katepavlu/MICROMOUSE/PCB/electronix.pdf

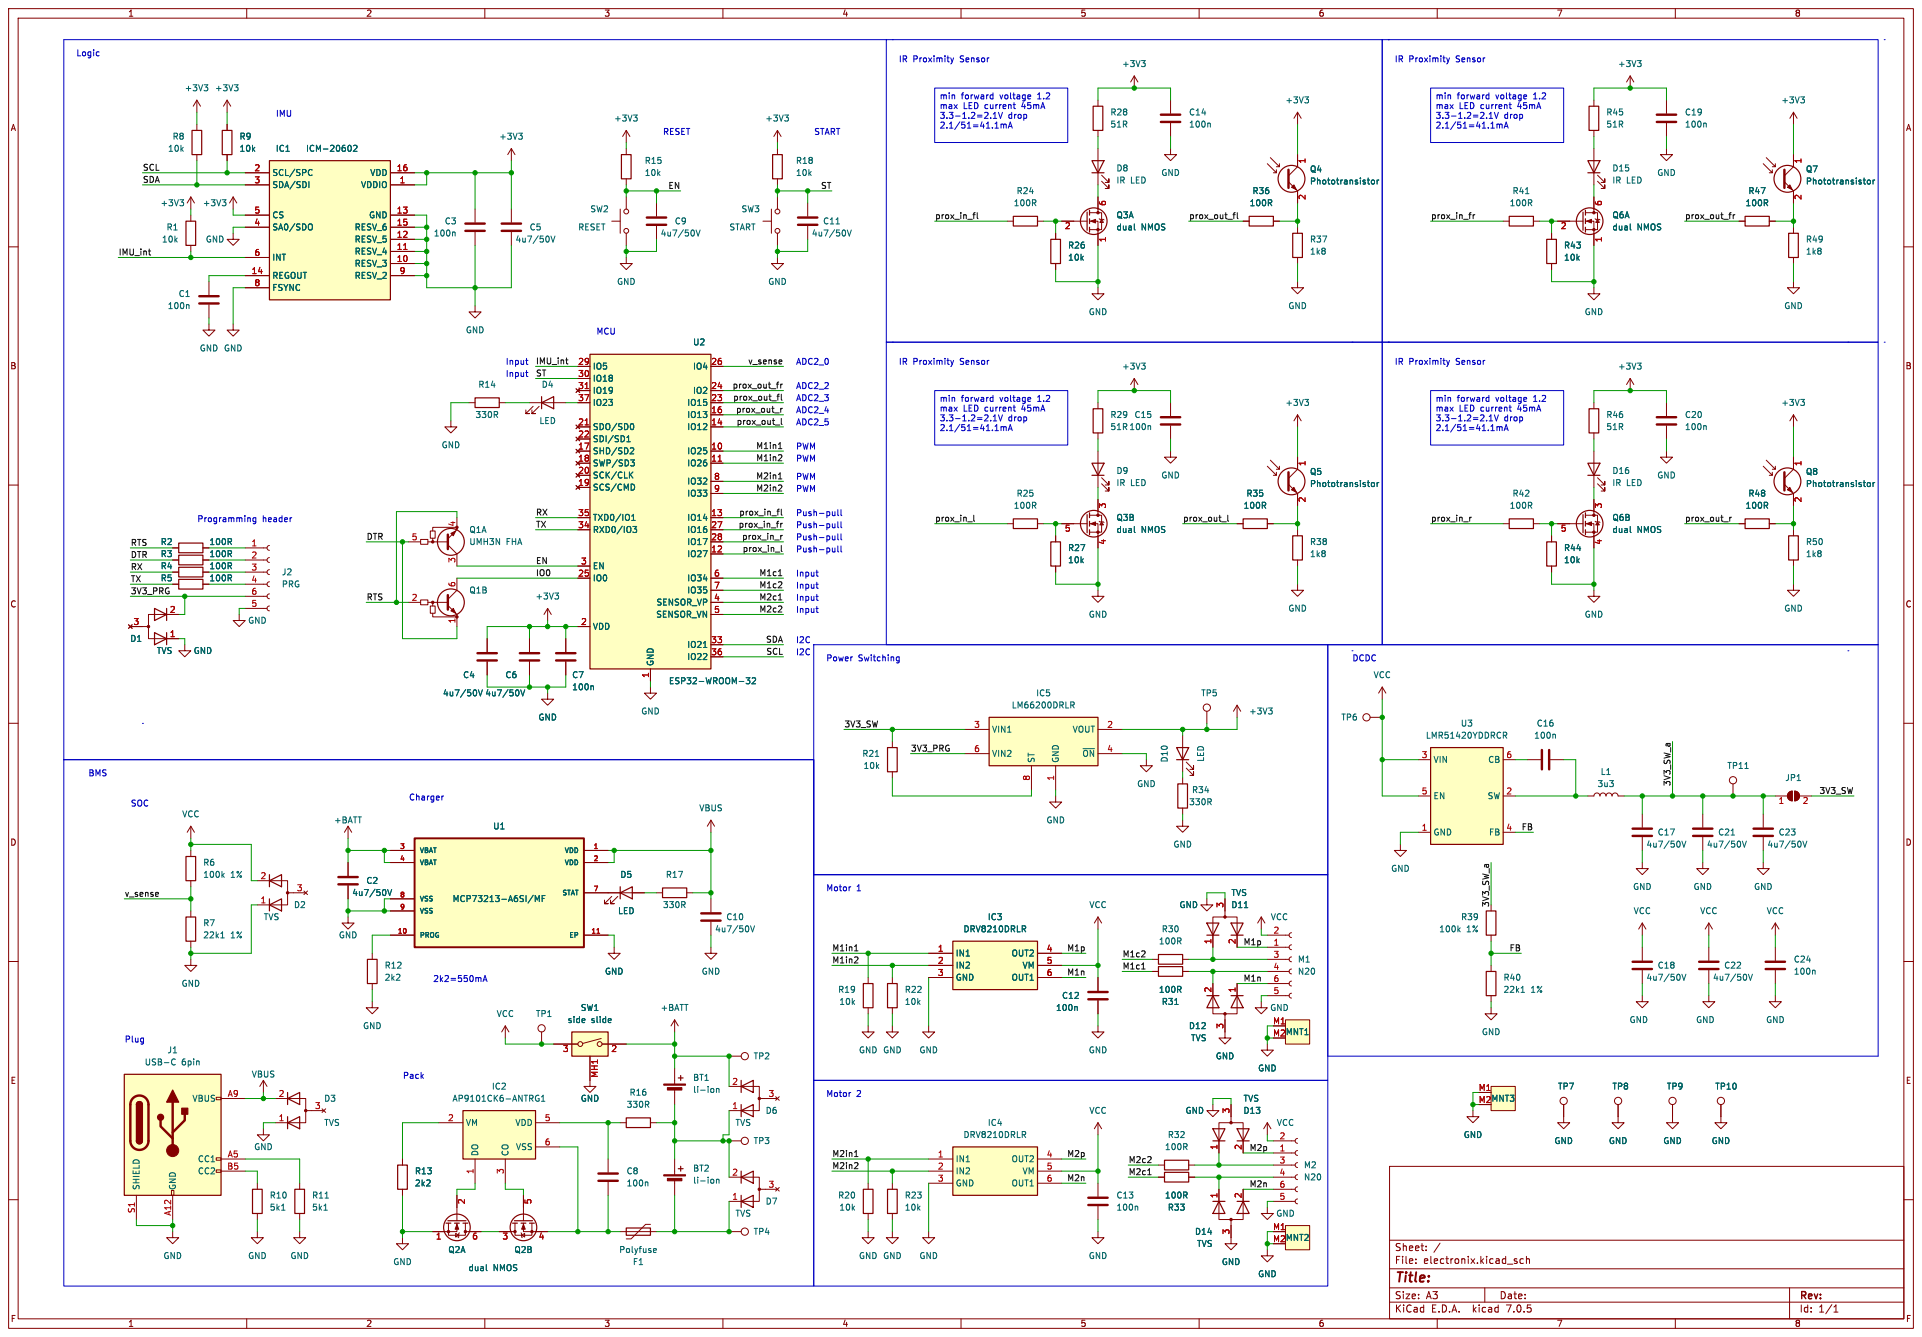
[picture p1: page 1]

2.1/51=41.1mA min forward voltage 1.2 max LED current 45mA

IO33 9 U2 ESP32-WROOM-32 D4
prox_out_fr v_sense ST
IO13 16 SHD/SD2 17 SWP/SD3 18 SCS/CMD 19 VDD 2 SCK/CLK 20 SDO/SD0 21 SDI/SD1 22

10k U2 ESP32-WROOM-32 GND

Push-pullPower Switching Motor 2
