katepavlu/MICROMOUSE/PCB/electronix.kicad_pcb

## KiCad design PCB/electronix.kicad_pcb (2023-08-06)

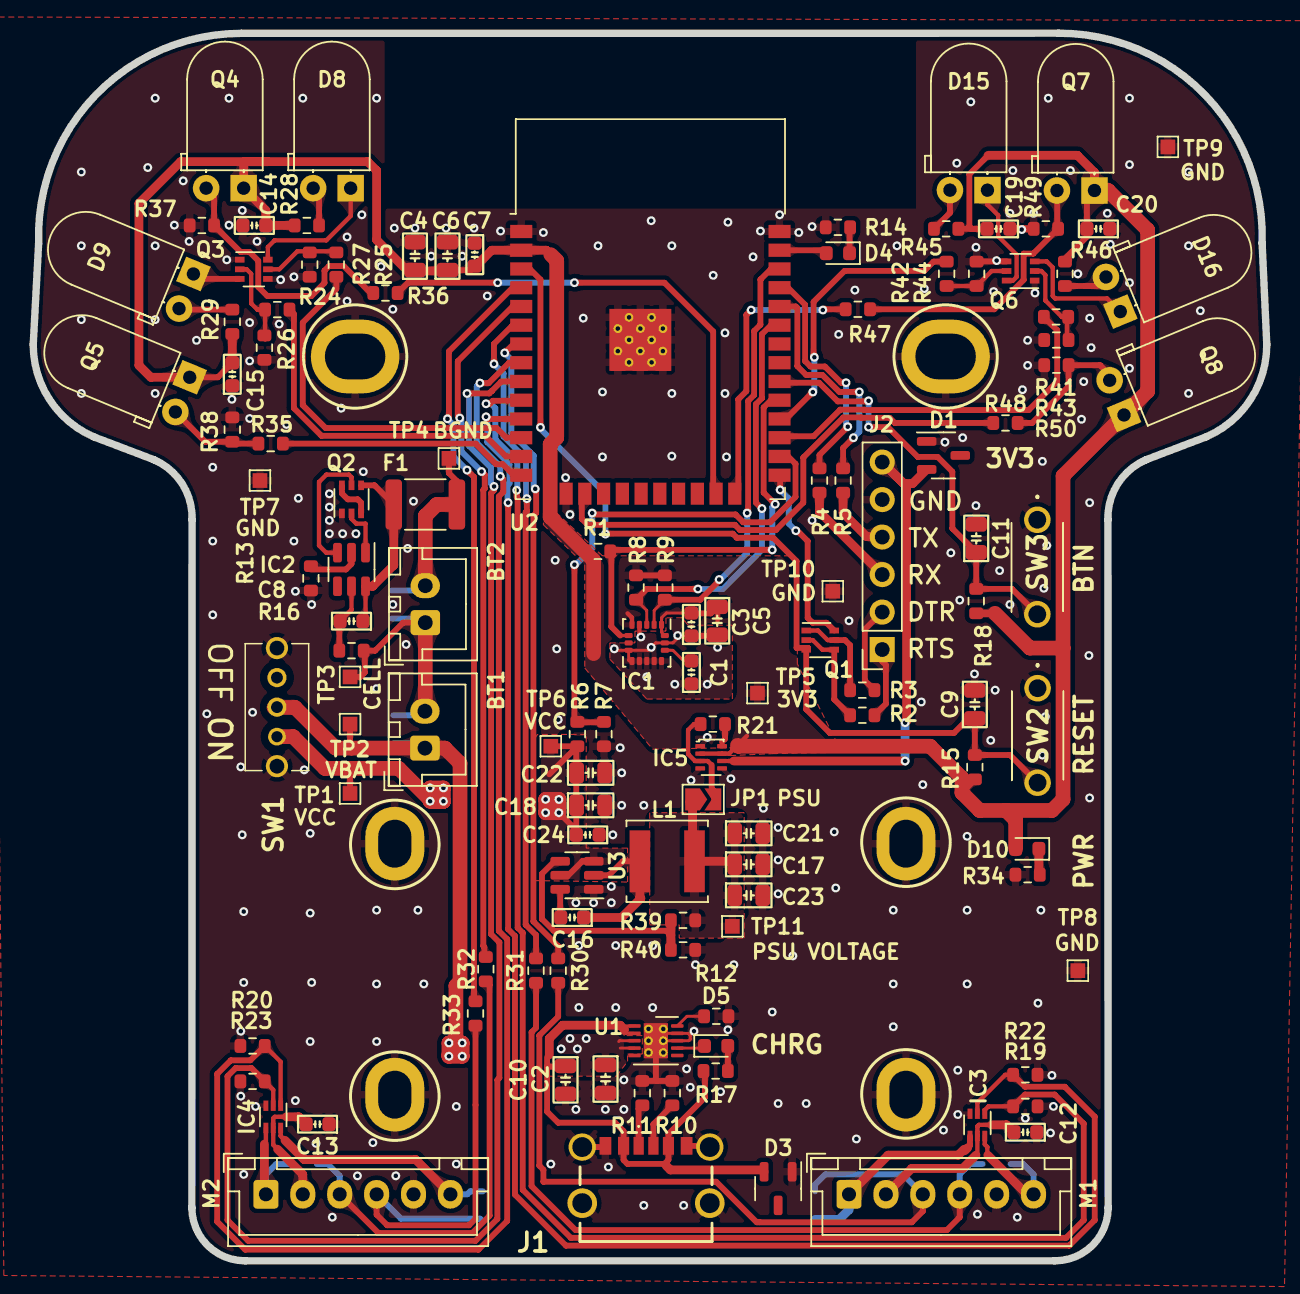
[picture p2: board electronix.kicad_pcb from above]

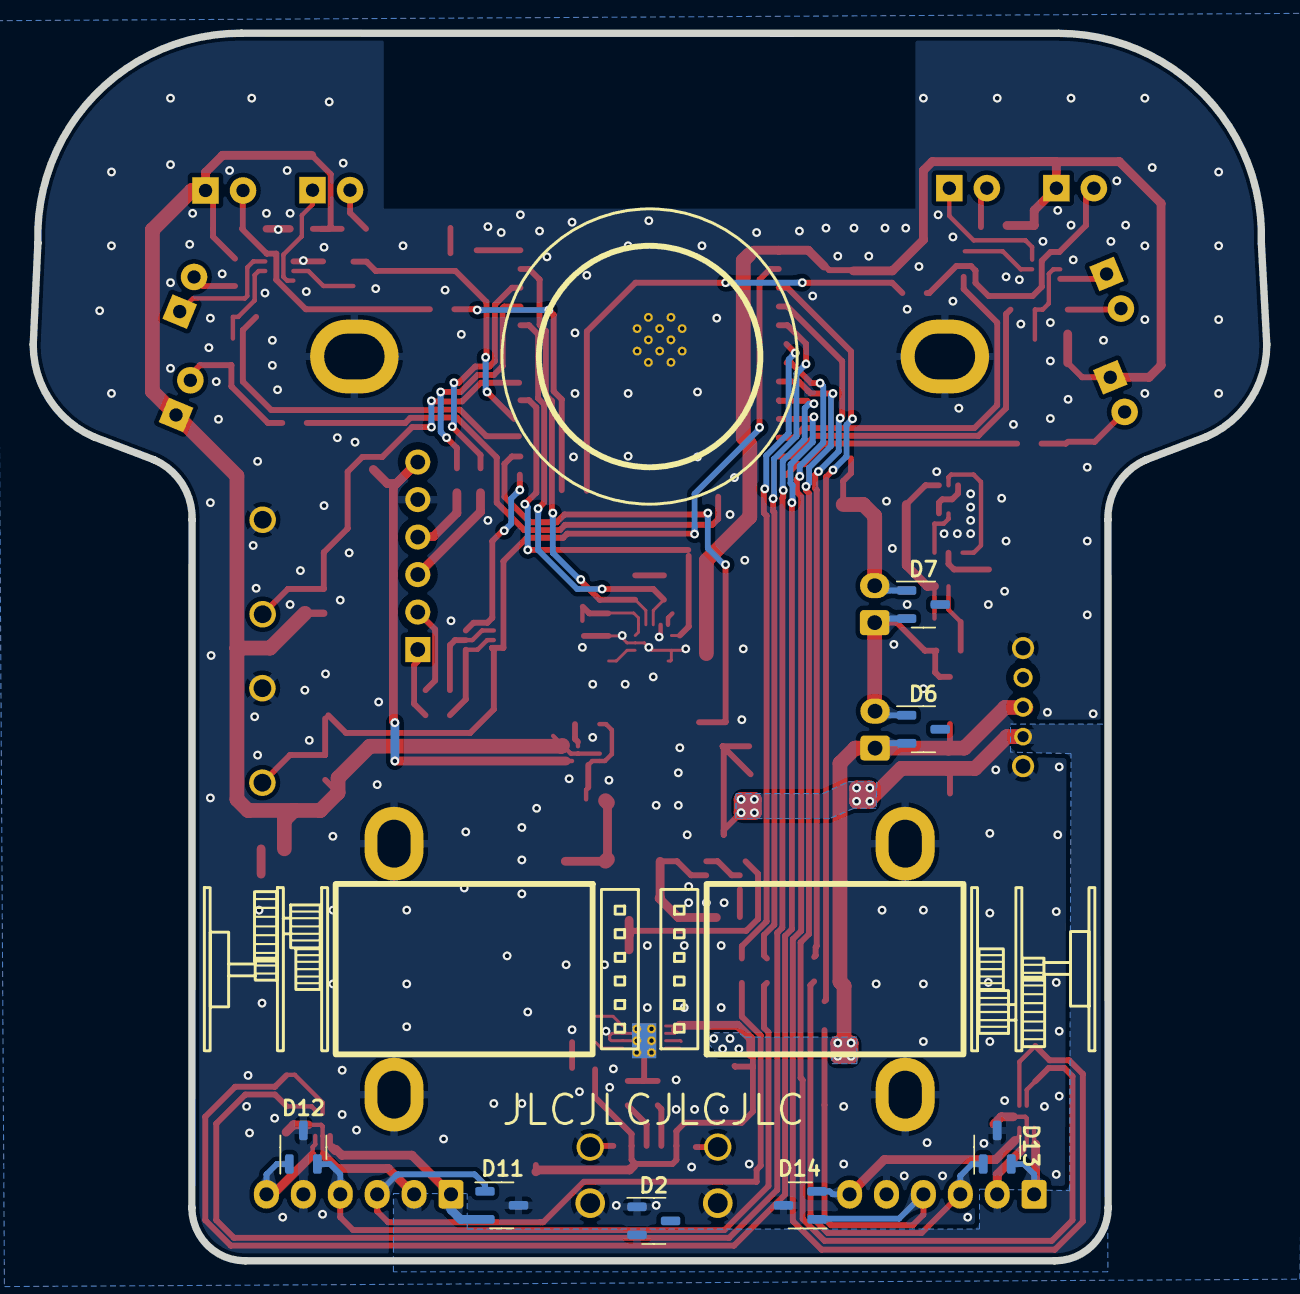
[picture p3: board electronix.kicad_pcb from below]

Board: 2 copper layers, 83.6 x 83.2 mm, 132 parts (10 on the bottom side), 84 nets.

Parts:
BT1, BT2: li-ion; JST_XH_B2B-XH-A_1x02_P2.50mm_Vertical
C1, C3, C7, C8, C12, C13, C14, C15, C16, C19, C20, C24: 100n; C_0603_1608Metric
C2, C4, C5, C6, C9, C10, C11, C17, C18, C21, C22, C23: 4u7/50V; C_0805_2012Metric
D1, D2, D3, D6, D7, D11, D12, D13, D14: PESD5V2S2UT; SOT-23-3
D4, D5, D10: LED; LED_0603_1608Metric
D8, D9, D15, D16: IR LED; LED_D5.0mm_Horizontal_O1.27mm_Z3.0mm
F1: Polyfuse; Fuse_1812_4532Metric
IC1: ICM-20602; LGA-16_3x3mm_P0.5mm_LayoutBorder3x5y
IC2: AP9101CK6-ANTRG1; SOT-23-6
IC3, IC4: DRV8210DRLR; SOT-563
IC5: LM66200DRLR; SOT-583-8
J1: USB-C 6pin; 1016435900011LF
J2: PRG; PinSocket_1x06_P2.54mm_Vertical
JP1: SolderJumper_2_Open; SolderJumper-2_P1.3mm_Open_TrianglePad1.0x1.5mm
L1: 3u3; L_Changjiang_FNR5040S
M1, M2: N20; JST_XH_B6B-XH-A_1x06_P2.50mm_Vertical
MNT1, MNT2: N20 encoder motor
MNT3: Ball support
Q1: UMH3N FHA; SOT-363_SC-70-6
Q2, Q3, Q6: dual NMOS; SOT-363_SC-70-6
Q4, Q5, Q7, Q8: Phototransistor; LED_D5.0mm_Horizontal_O1.27mm_Z3.0mm_IRBlack
R1, R8, R9, R15, R18, R19, R20, R21, R22, R23, R26, R27, R43, R44: 10k; R_0603_1608Metric
R2, R3, R4, R5, R24, R25, R30, R31, R32, R33, R35, R36, R41, R42, R47, R48: 100R; R_0603_1608Metric
R6, R39: 100k 1%; R_0603_1608Metric
R7, R40: 22k1 1%; R_0603_1608Metric
R10, R11: 5k1; R_0603_1608Metric
R12, R13: 2k2; R_0603_1608Metric
R14, R16, R17, R34: 330R; R_0603_1608Metric
R28, R29, R45, R46: 51R; R_0603_1608Metric
R37, R38, R49, R50: 1k8; R_0603_1608Metric
SW1: side slide; 18252321
SW2: RESET; PTS636SL50LFS
SW3: START; PTS636SL50LFS
TP1, TP2, TP3, TP4, TP5, TP6, TP7, TP8, TP9, TP10, TP11: TestPoint; TestPoint_Pad_1.0x1.0mm
U1: MCP73213-A6SI/MF; DFN-10-1EP_3x3mm_P0.5mm_EP1.65x2.38mm_ThermalVias
U2: ESP32-WROOM-32
U3: LMR51420YDDRCR; SOT-23-6

Connections:
+3V3: C3.2, C4.1, C5.1, C6.1, C7.2, C14.2, C15.2, C19.2, C20.2, D10.2 (A), IC1.1 (VDDIO), IC1.5 (CS), IC1.16 (VDD), IC5.2 (VOUT), IC5.7 (VOUT), Q4.1 (C), Q5.1 (C), Q7.1 (C), Q8.1 (C), R1.1, R8.1, R9.1, R15.1, R18.1, R28.1, R29.1, R45.1, R46.1, TP5.1, U2.2 (VDD)
+BATT: BT1.1 (+), C2.1, D6.2 (K), SW1.2, TP2.1, U1.3 (VBAT), U1.4 (VBAT)
/3V3_PRG: D1.2 (K), IC5.6 (VIN2), J2.6
/3V3_SW: IC5.3 (VIN1), JP1.2 (B), R21.1
/3V3_SW_a: C17.1, C21.1, C23.1, JP1.1 (A), L1.2, R39.1, TP11.1
/DTR: Q1.1 (E1), Q1.5 (B1), R3.1
/EN: C9.1, Q1.3 (C1), R15.2, SW2.2, U2.3 (EN)
/FB: R39.2, R40.1, U3.4 (FB)
/IMU_int: IC1.6 (INT), R1.2, U2.29 (IO5)
/IO0: Q1.6 (C1), U2.25 (IO0)
/M1c1: R31.1, U2.6 (IO34)
/M1c2: R30.1, U2.7 (IO35)
/M1in1: IC3.1 (IN1), R19.2, U2.10 (IO25)
/M1in2: IC3.2 (IN2), R22.1, U2.11 (IO26)
/M1n: D12.1 (K), IC3.6 (OUT1), M1.6
/M1p: D11.2 (K), IC3.4 (OUT2), M1.1
/M2c1: R33.1, U2.4 (SENSOR_VP)
/M2c2: R32.1, U2.5 (SENSOR_VN)
/M2in1: IC4.1 (IN1), R20.1, U2.8 (IO32)
/M2in2: IC4.2 (IN2), R23.1, U2.9 (IO33)
/M2n: D14.2 (K), IC4.6 (OUT1), M2.6
/M2p: D13.2 (K), IC4.4 (OUT2), M2.1
/RTS: Q1.2 (B1), Q1.4 (E1), R2.1
/RX: R4.1, U2.35 (TXD0/IO1)
/SCL: IC1.2 (SCL/SPC), R9.2, U2.36 (IO22)
/SDA: IC1.3 (SDA/SDI), R8.2, U2.33 (IO21)
/ST: C11.1, R18.2, SW3.2, U2.30 (IO18)
/TX: R5.1, U2.34 (RXD0/IO3)
/prox_in_fl: R24.1, U2.13 (IO14)
/prox_in_fr: R41.1, U2.27 (IO16)
/prox_in_l: R25.1, U2.12 (IO27)
/prox_in_r: R42.1, U2.28 (IO17)
/prox_out_fl: R36.1, U2.23 (IO15)
/prox_out_fr: R47.1, U2.24 (IO2)
/prox_out_l: R35.1, U2.14 (IO12)
/prox_out_r: R48.1, U2.16 (IO13)
/v_sense: R6.2, R7.1, U2.26 (IO4)
GND: C1.1, C2.2, C3.1, C4.2, C5.2, C6.2, C7.1, C9.2, C10.2, C11.2, C12.1, C13.1, C14.1, C15.1, C17.2, C18.2, C19.1, C20.1, C21.2, C22.2, C23.2, C24.1, D1.1 (K), D2.1 (K), D3.1 (K), D11.3 (A), D12.3 (A), D13.3 (A), D14.3 (A), IC1.4 (SA0/SDO), IC1.8 (FSYNC), IC1.9 (RESV_2), IC1.10 (RESV_3), IC1.11 (RESV_4), IC1.12 (RESV_5), IC1.13 (GND), IC1.15 (RESV_6), IC3.3 (GND), IC4.3 (GND), IC5.1 (GND), IC5.4 (~ON), IC5.5 (GND), J1.A12 (GND), J1.B12 (GND), J1.S1 (SHIELD), J1.S2 (SHIELD), J1.S3 (SHIELD), J1.S4 (SHIELD), J2.5, M1.5, M2.5, MNT1.M1, MNT1.M2, MNT2.M1, MNT2.M2, MNT3.M1, MNT3.M2, Q2.1 (S), Q3.1 (S), Q3.4 (S), Q6.1 (S), Q6.4 (S), R7.2, R10.2, R11.2, R12.2, R13.2, R14.1, R19.1, R20.2, R22.2, R23.2, R26.2, R27.2, R34.1, R37.1, R38.1, R40.2, R43.2, R44.2, R49.1, R50.1, SW1.MH1 (SHIELD), SW1.MH2 (SHIELD), SW2.1, SW3.1, TP7.1, TP8.1, TP9.1, TP10.1, U1.8 (VSS), U1.9 (VSS), U1.11 (EP), U2.1 (GND), U2.15 (GND), U2.38 (GND), U2.39 (GND), U3.1 (GND)
unnamed: BT1.2 (-), BT2.1 (+), D6.1 (K), D7.2 (K), R16.2, TP3.1
unnamed: BT2.2 (-), D7.1 (K), F1.2, TP4.1
unnamed: D4.2 (A), U2.37 (IO23)
unnamed: D4.1 (K), R14.2
unnamed: D5.2 (A), R17.1
unnamed: D5.1 (K), U1.7 (STAT)
unnamed: D8.2 (A), R28.2
unnamed: D8.1 (K), Q3.6 (D)
unnamed: D9.2 (A), R29.2
unnamed: D9.1 (K), Q3.3 (D)
unnamed: D10.1 (K), R34.2
unnamed: D15.2 (A), R45.2
unnamed: D15.1 (K), Q6.6 (D)
unnamed: D16.2 (A), R46.2
unnamed: D16.1 (K), Q6.3 (D)
unnamed: C1.2, IC1.14 (REGOUT)
unnamed: IC2.3 (CO), Q2.5 (G)
unnamed: IC2.1 (DO), Q2.2 (G)
unnamed: C8.2, IC2.5 (VDD), R16.1
unnamed: IC2.2 (VM), R13.1
unnamed: C8.1, F1.1, IC2.6 (VSS), Q2.4 (S)
unnamed: IC5.8 (ST), R21.2
unnamed: J1.A5 (CC1), R11.1
unnamed: J1.B5 (CC2), R10.1
unnamed: J2.1, R2.2
unnamed: J2.2, R3.2
unnamed: J2.3, R4.2
unnamed: J2.4, R5.2
unnamed: D11.1 (K), M1.3, R30.2
unnamed: D12.2 (K), M1.4, R31.2
unnamed: D13.1 (K), M2.3, R32.2
unnamed: D14.1 (K), M2.4, R33.2
unnamed: Q2.3 (D), Q2.6 (D)
unnamed: Q3.2 (G), R24.2, R26.1
unnamed: Q3.5 (G), R25.2, R27.1
unnamed: Q4.2 (E), R36.2, R37.2
unnamed: Q5.2 (E), R35.2, R38.2
unnamed: Q6.2 (G), R41.2, R43.1
unnamed: Q6.5 (G), R42.2, R44.1
unnamed: Q7.2 (E), R47.2, R49.2
unnamed: Q8.2 (E), R48.2, R50.2
unnamed: R12.1, U1.10 (PROG)
unnamed: C16.2, U3.6 (CB)
unnamed: C16.1, L1.1, U3.2 (SW)
VBUS: C10.1, D3.2 (K), J1.A9 (VBUS), J1.B9 (VBUS), R17.2, U1.1 (VDD), U1.2 (VDD)
VCC: C12.2, C13.2, C18.1, C22.1, C24.2, D2.2 (K), IC3.5 (VM), IC4.5 (VM), M1.2, M2.2, R6.1, SW1.3, TP1.1, TP6.1, U3.3 (VIN), U3.5 (EN)
