katepavlu/MICROMOUSE/(commit log)

2023-05-29 make kicad project make motor parts start working on sensor
    [electronix.kicad_pcb, electronix.kicad_sch]
2023-05-31 finished schematic? removed unnecessary subfolder
    [electronix.kicad_pcb, electronix.kicad_sch]
2023-05-31 Add start button General schematic edits Add Mouser BOM
    [Basket_May31_0305PM.xls, electronix.kicad_sch]
2023-05-31 add schematic PDF
2023-06-01 Assign fooprints Finish BOM Fix libraries Generic footprints where applicable ERC - remove erroneous net labels Start working on layout
    [Basket_May31_0305PM.xls, Mouser_order.xls, electronix.kicad_pcb, electronix.kicad_sch]
2023-06-01 Update PDF schematic
2023-06-02 Layout Add diode on prg connector remove diode on PSU to avoid driving motors from 3V3 Footprints for motors and omniwheel
    [electronix.kicad_pcb, electronix.kicad_sch]
2023-06-02 add bigger ESP32 bypass
    [electronix.kicad_pcb, electronix.kicad_sch]
2023-06-03 Layout edits Power line hardening Fabrication outputs
    [electronix-B_Mask.gbs, electronix-B_Paste.gbp, electronix-B_Silkscreen.gbo, electronix-Back.gbl, electronix-Edge_Cuts.gm1, electronix-F_Mask.gts, electronix-F_Paste.gtp, electronix-F_Silkscreen.gto]
2023-06-03 add outputs to gitignore
    [electronix-B_Mask.gbs, electronix-B_Paste.gbp, electronix-B_Silkscreen.gbo, electronix-Back.gbl, electronix-Edge_Cuts.gm1, electronix-F_Mask.gts, electronix-F_Paste.gtp, electronix-F_Silkscreen.gto]
2023-06-03 new outputs
    [electronix-B_Mask.gbs, electronix-B_Paste.gbp, electronix-B_Silkscreen.gbo, electronix-Back.gbl, electronix-Edge_Cuts.gm1, electronix-F_Mask.gts, electronix-F_Paste.gtp, electronix-F_Silkscreen.gto]
2023-06-03 deleted outputs
    [electronix-B_Mask.gbs, electronix-B_Paste.gbp, electronix-B_Silkscreen.gbo, electronix-Back.gbl, electronix-Edge_Cuts.gm1, electronix-F_Mask.gts, electronix-F_Paste.gtp, electronix-F_Silkscreen.gto]
2023-06-03 EMI Hardening
    Rerouted back layer tracks whereever possible to create a continuous ground plane
    Added local vias to all gnd pins
    Added via stitching to overhanging areas from the front
    [electronix.kicad_pcb]
2023-06-03 Add power source switching Add Mouser PN to parts to enable BOM generation Moved PWR indicator to side of board
    [Mouser_order.xls, electronix.kicad_pcb, electronix.kicad_sch]
2023-06-03 Finishing touches shorten ground plane cuts fillet polygon pours add test points and PSU bringup jumper differentiate capacitor footprints by silkscreen
    [electronix.kicad_pcb, electronix.kicad_sch]
2023-06-03 ESD hardening
    [electronix.kicad_pcb, electronix.kicad_sch]
2023-06-04 ESD layout edits Add TVS part numbers
    [electronix.kicad_pcb, electronix.kicad_sch]
2023-06-04 increase minimum hole size to 0.3
    [electronix.kicad_pcb]
2023-08-06 Add proximity sensor simulations
    [electronix_sim.kicad_pcb, electronix_sim.kicad_sch]
2023-08-06 Update ibom.html, electronix.kicad_pcb, and electronix.kicad_sch
    [electronix.kicad_pcb, electronix.kicad_sch]
2023-08-06 Start work on software - proximity sensors & state of charge
2023-08-06 extract the adc and sensors to a separate file
2023-08-06 add imu support
2023-08-16 Serial Studio now runs wirelessly via Bluetooth SPP Add motor co trol dependencies
